dngtuankiet/aes-gcm_128-256/docs_v2/build_images/synthesis_100MHz.JPG

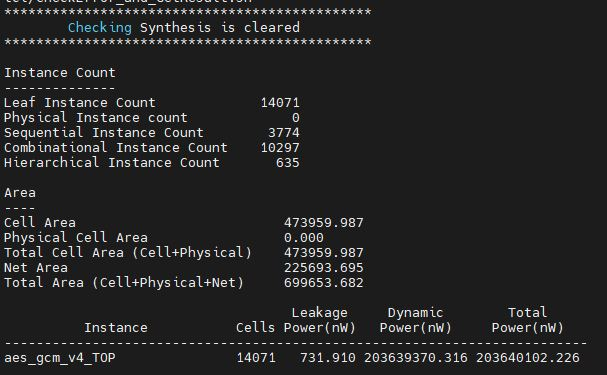
docs_v2/build_images/synthesis_100MHz.JPG
