dngtuankiet/aes-gcm_128-256/docs_v2/aes-gcm_v2/spec/spec.docx

AES-GCM

BLOCK DIAGRAMs

and STATE MACHINEs

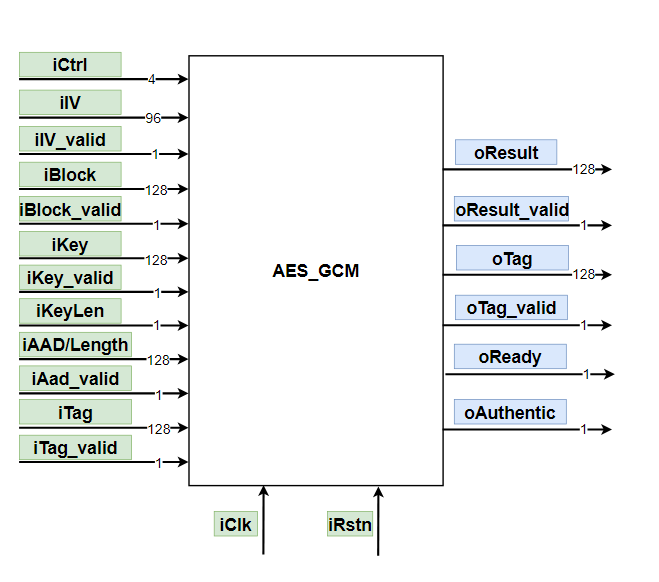
[picture p3: figure]

PIN | Direction | Width | Description
iClk | Input | 1 | Clock
iRstn | Input | 1 | Negative edge reset: reset after using the core

CONTROL
iCtrl | Input | ４ | Initialize signal: assert when using the core
oReady | Output | 1 | Output ready signal: input new data when ready is asserted

DATA
iIV | Input | 96 | 96-bit length IV
iIV_valid | Input | 1 | When asserted, IV is valid
iKey | Input | 256 | Key
iKey_valid | Input | 1 | When asserted, Key is valid
iKey_len | Input | 1 | When asserted, Key length is 256-bit. When deasserted, Key length is 128-bit.
iAad | Input | 128 | Additional Authentic Data or Length(A,C): when Ready = 1, change data every clock cycle
iAad_valid | Input | 1 | When asserted, AAD is valid.
iBlock | Input | 128 | Input Plaintext or Ciphertext.
iBlock_valid | Input | 1 | When asserted, Plaintext or Ciphertext is valid.
iTag | Input | 128 | Input Tag for authentication in Decryption mode
iTag_valid | Input | 1 | When asserted, Tag is valid

OUTPUT
oResult | Output | 128 | Output Ciphertext or Ciphertext
oResult_valid | Output | 1 | When asserted, Result is valid
oTag | Output | 128 | Output Tag in Encryption mode.
oTag_valid | Output | 1 | When asserted, output Tag is valid
oAuthentic | Output | 1 | When asserted, indicating authentic Block in Decryption mode.

Name | AES_GCM
File | aes_gcm.v

Submodule | File
GCTR_BLOCK | gctr_block.v
GHASH_BLOCK | ghash_block.v

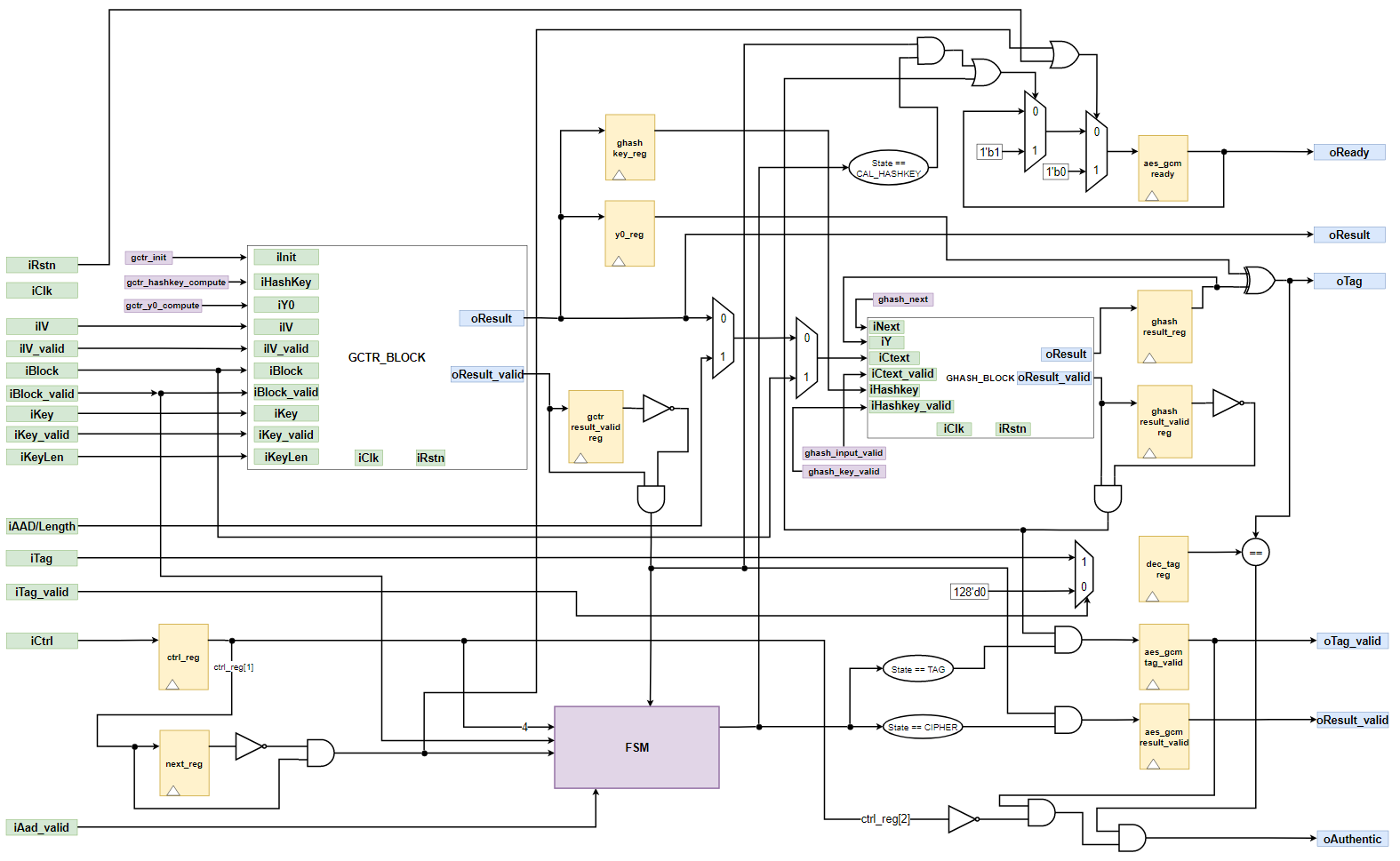
[picture p4: figure]
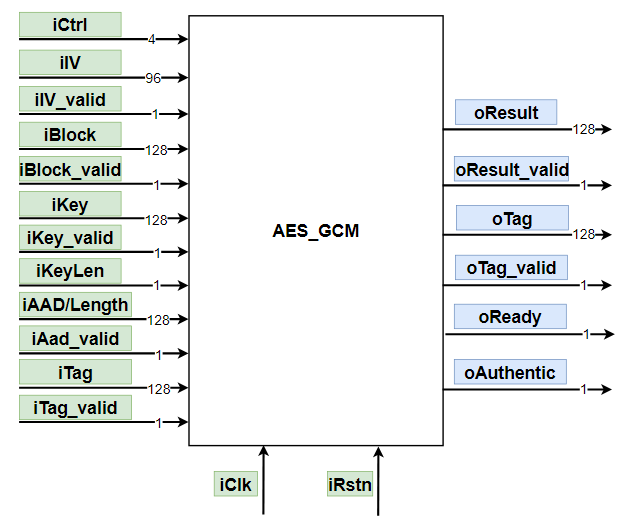
[picture p5: figure]
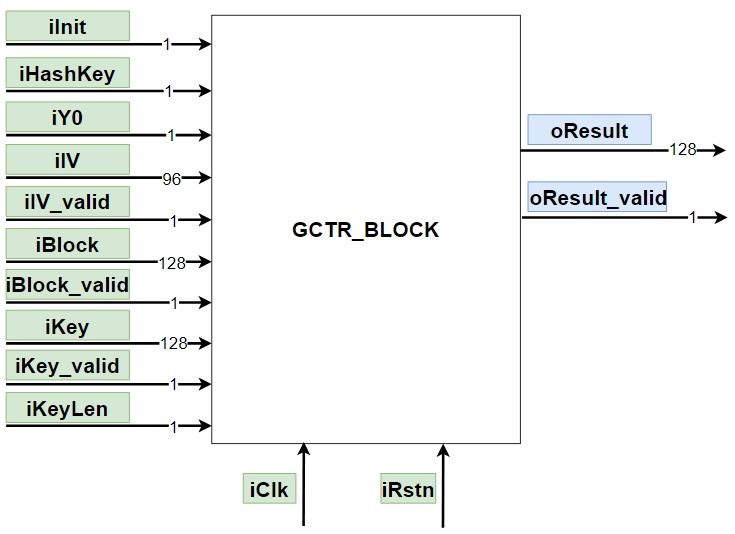
[picture p6: figure]
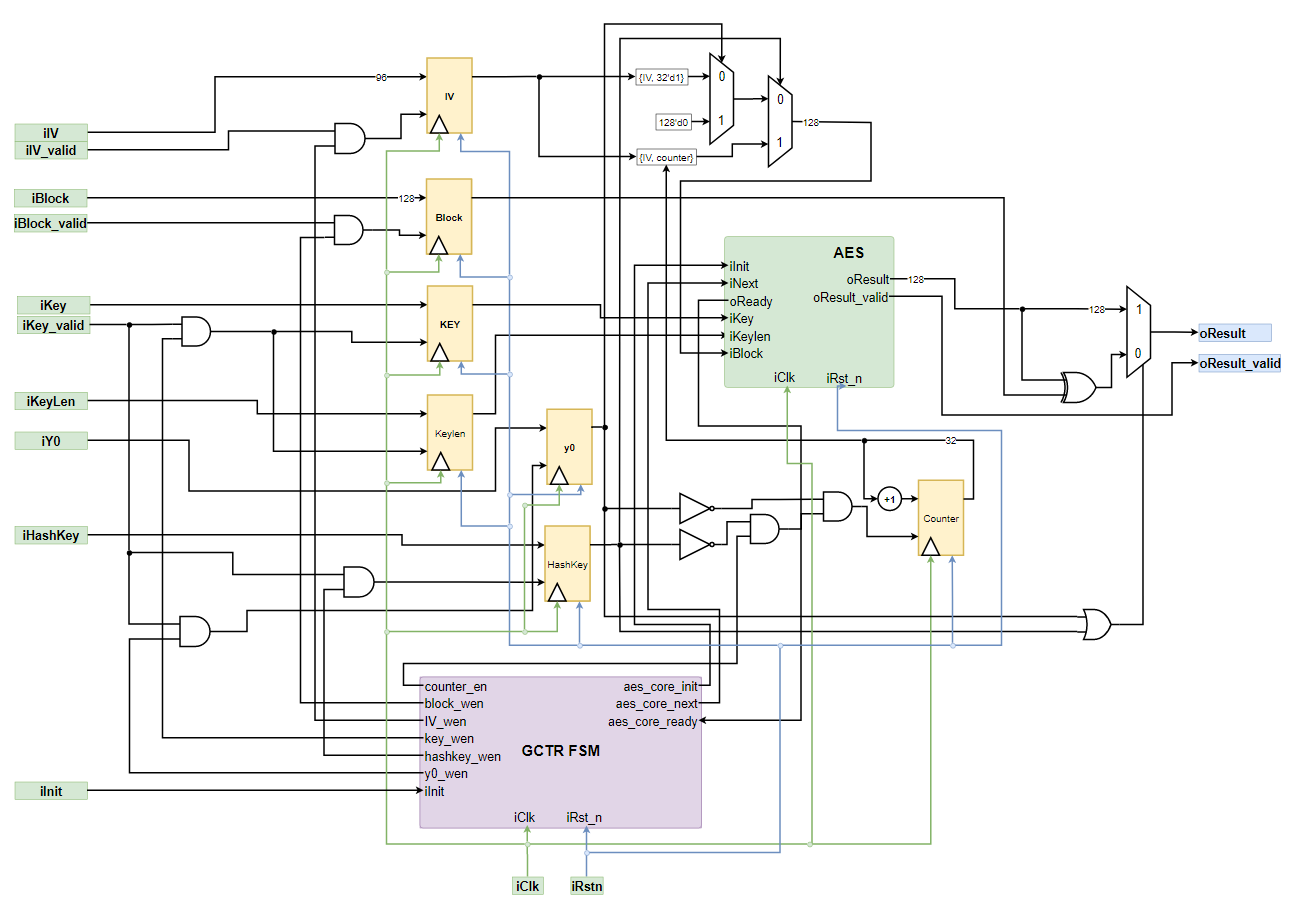
[picture p7: figure]

Submodule | File
AES | aes_core.v

Name | GCTR_BLOCK
File | gctr_block.v

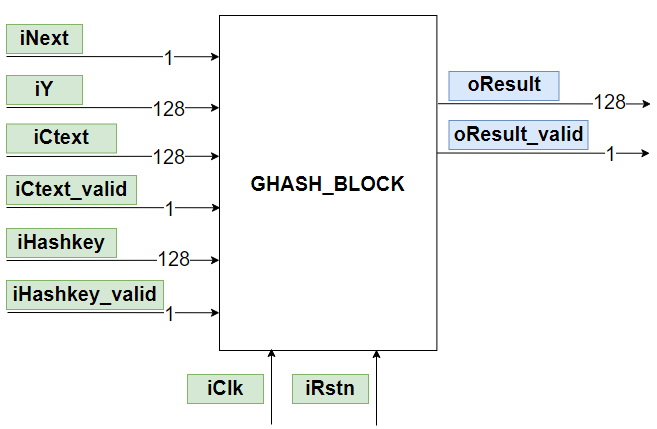
[picture p8: figure]
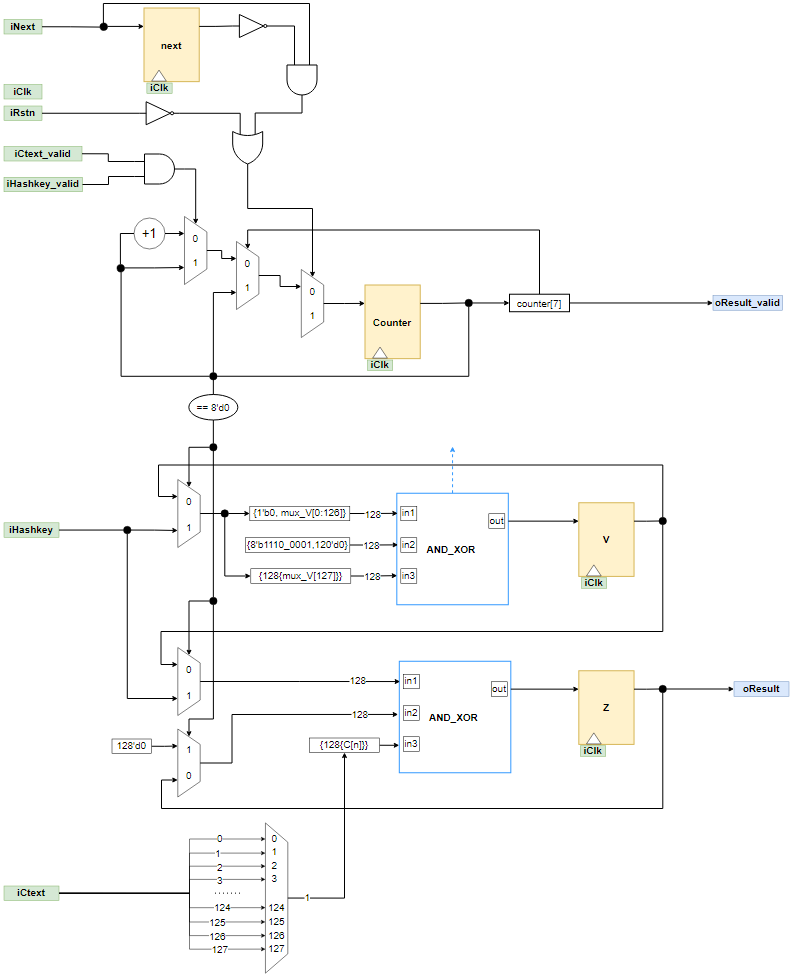
[picture p9: figure]
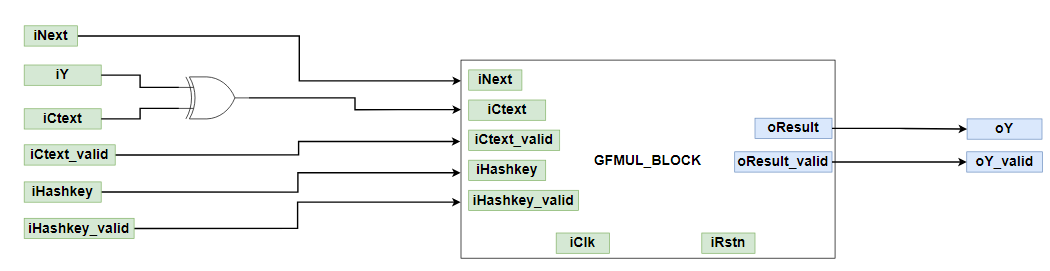
[picture p10: figure]

Submodule | File
GF_MUL | gfmul.v

Name | GHASH_BLOCK
File | ghash_block.v

STATE MACHINEs

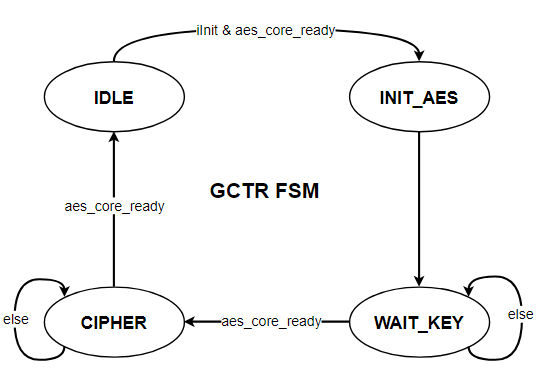
[picture p11: figure]
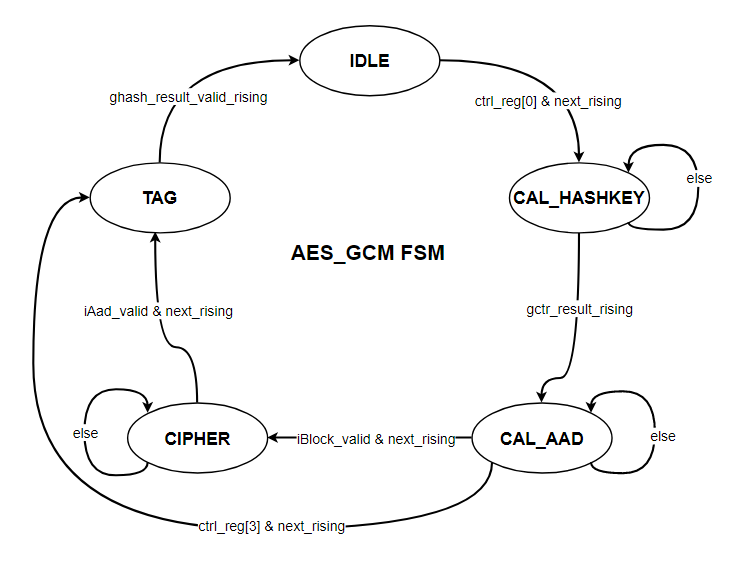
[picture p12: figure]

AES_GCM FSM

IDLE

gctr_init = 1’b0

gctr_hashkey_compute = 1’b0

gctr_y0_compute = 1’b0

ghash_next = 1’b0

ghash_input_signal = 2’b00

ghash_input_valid = 1’b0

ghash_key_wen = 1’b0

ghash_key_valid = 1’b0

ghash result_wen = 1’b0

y0_wen = 1’b0

CAL_HASHKEY

if(gctr_result_valid)

gctr_init = 1’b0

else

gctr_init = 1’b1

gctr_hashkey_compute = 1’b1

gctr_y0_compute = 1’b0

ghash_next = 1’b0

ghash_input_signal = 2’b00

ghash_input_valid = 1’b0

if(gctr_result_valid)

gctr_key_wen = 1’b1

gahsh_key_valid = 1’b1

else

gctr_key_wen = 1’b0

gahsh_key_valid = 1’b0

ghash_result_wen = 1’b0

y0_wen = 1’b0

CAL_AAD

if(next_rising & (iBlock_valid | ctrl_reg[3]))

gctr_init = 1’b1

else

gctr_init = 1’b0

gctr_hashkey_compute = 1’b0

gctr_y0_compute = 1’b0

ghash_next = next_rising

ghash_input_signal = 2’b01

ghash_input_valid = iAad_valid

ghash_key_wen = 1’b0

ghash_key_valid = 1’b1

if(ghash_result_valid_rising)

ghash_result_wen = 1’b1

else

ghash_result_wen = 1’b0

y0_wen = 1’b0

CIPHER

if(next_rising)

gctr_init = 1’b1

else

gctr_init = 1’b0

gctr_hashkey_compute = 1’b1

gctr_y0_compute = 1’b0

ghash_next = gctr_result_rising

if(ctrl_reg[2])

ghash_input_signal = 2’b00

else

ghash_input_signal = 2’b10

ghash_input_valid = gctr_result_valid

ghash_key_wen = 1’b0

ghash_key_valid = 1’b1

if(ghash_result_valid_rising)

ghash_result_wen = 1’b1

else

ghash_result_wen = 1’b0

y0_wen = 1’b0

TAG

gctr_init = 1’b0

gctr_hashkey_compute = 1’b0

gctr_y0_compute = 1’b1

ghash_next = gctr_result_rising

ghash_input_signal = 2’b01

ghash_input_valid = gctr_result_valid

ghash_key_wen = 1’b0

ghash_key_valid = 1’b1

if(ghash_result_valid_rising)

ghash_result_wen = 1’b1

else

ghash_result_wen = 1’b0

if(gctr_result_rising)

y0_wen = 1’b1

else

y0_wen = 1’b0

GCTR FSM

IDLE

counter_en = 1’b0

block_wen = 1’b0

IV_wen = 1’b0

key_wen = 1’b0

hashkey_wen = 1’b0

y0_wen = 1’b0

aes_core_init = 1’b0

aes_core_next = 1’b0

gctr_result_valid = aes_core_output_valid

INIT_AES

counter_en = 1’b0

block_wen = 1’b1

IV_wen = 1’b1

key_wen = 1’b1

hashkey_wen = 1’b1

y0_wen = 1’b1

aes_core_init = 1’b1

aes_core_next = 1’b0

gctr_result_valid = 1’b0

WAIT_KEY

counter_en = 1’b0

block_wen = 1’b0

IV_wen = 1’b0

key_wen = 1’b0

hashkey_wen = 1’b0

y0_wen = 1’b0

aes_core_init = 1’b0

aes_core_next = 1’b0

gctr_result_valid = 1’b0

CIPHER

counter_en = 1’b1

block_wen = 1’b0

IV_wen = 1’b0

key_wen = 1’b0

hashkey_wen = 1’b0

y0_wen = 1’b0

aes_core_init = 1’b0

aes_core_next = 1’b1

gctr_result_valid = 1’b0

Multiplication in GF(2¹²⁸)

Each element is a vector of 128 bits. The ith bit of an element X is denoted as Xi. The leftmost bit is Xi and the rightmost bit is X127. The multiplication operation uses the special element R = 1110001||0, and is defined in Algorithm 1. The argument rightshift() moves the bits of its argument one bit to the right. More formally, whenever W = rightshift(V), then Wi = Vi-1 for 1 <= i <= 127 and W0 = 0.

What we want to compute: oY = gf_mul(iHashKey, iCtext ^ iY)

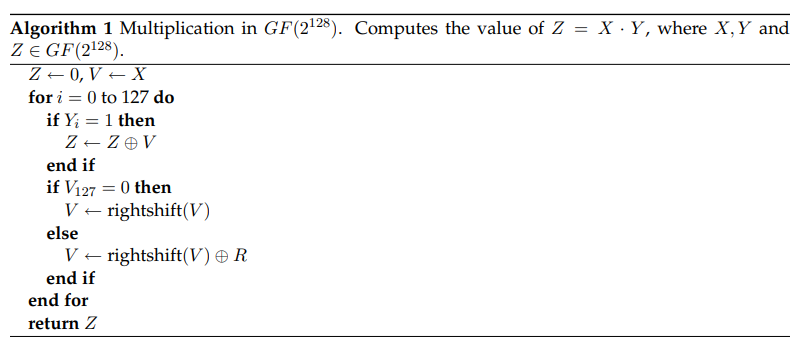
[picture p13: figure]
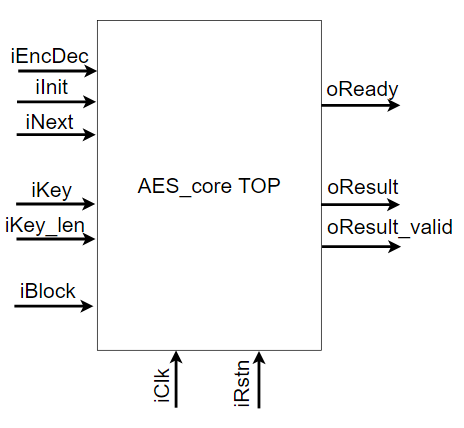
[picture p14: figure]

URL: tee-hardware/hardware/teehw/optvsrc/AES at master · uec-hanken/tee-hardware (github.com) (https://github.com/uec-hanken/tee-hardware/tree/master/hardware/teehw/optvsrc/AES)

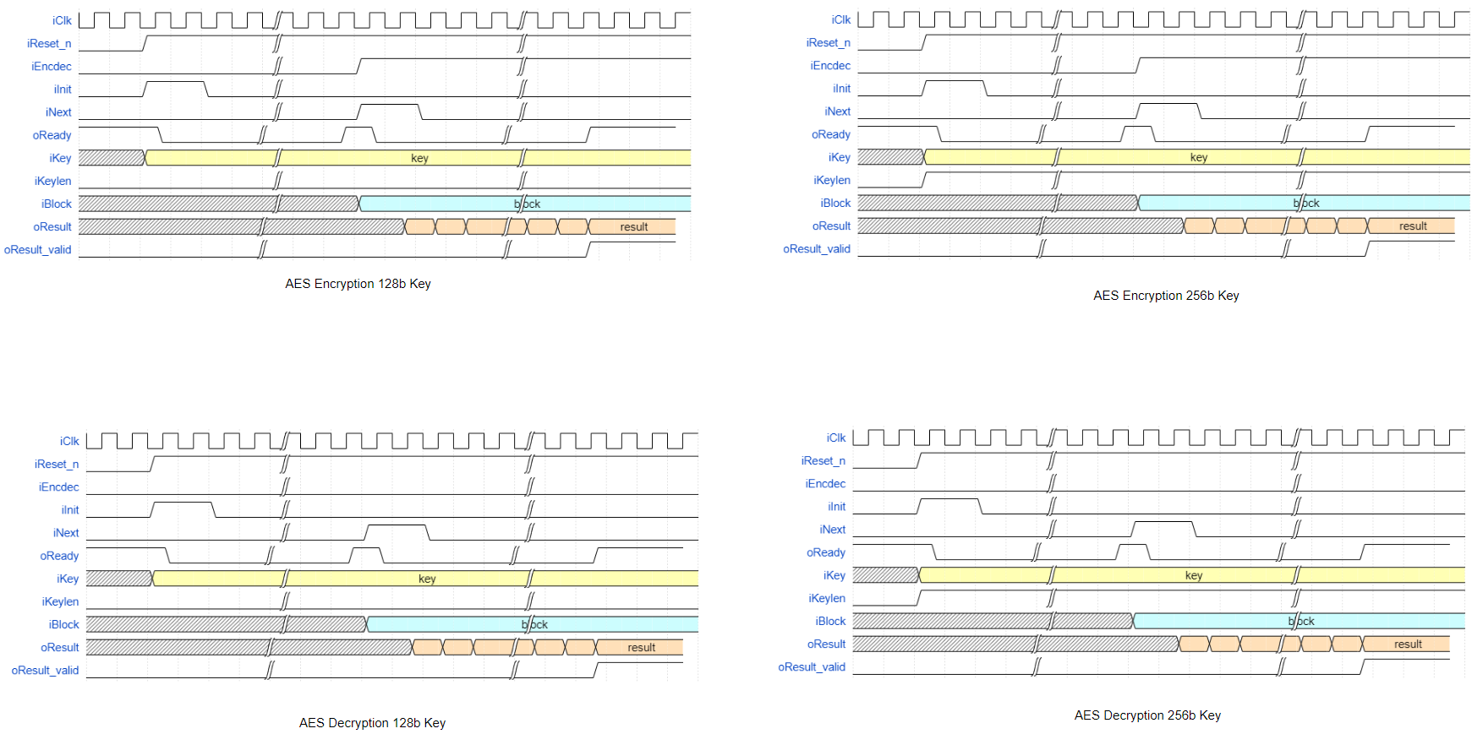
[picture p15: figure]
