dngtuankiet/aes-gcm_128-256/docs/new/spec.docx

AES GCM

BLOCK DIAGRAM

and STATE MACHINE

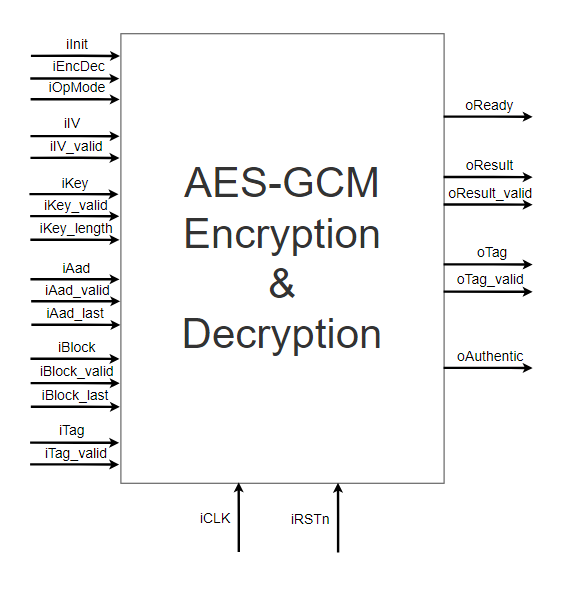
[picture p16: figure]
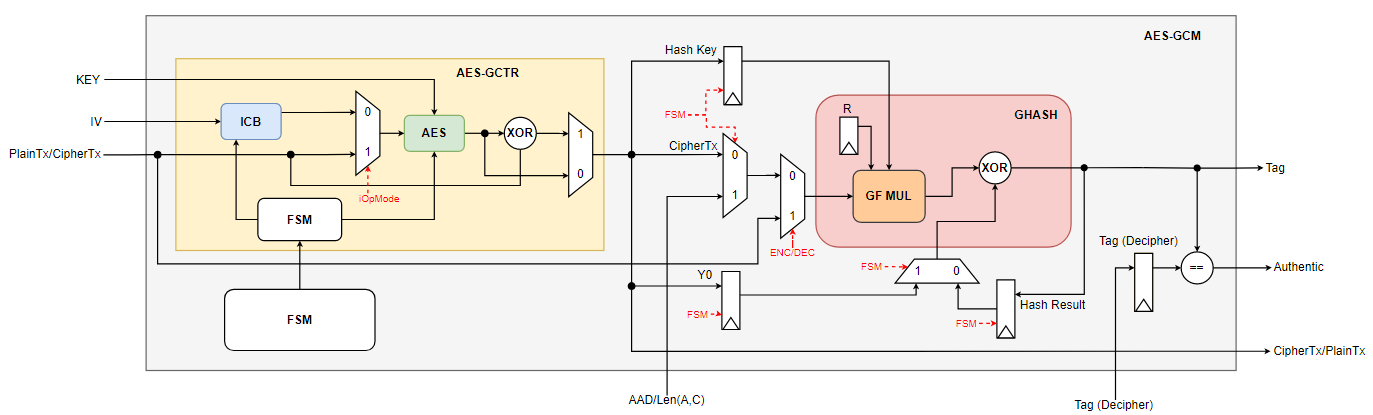
[picture p17: figure]

PIN | Direction | Width | Description
iClk | Input | 1 | Clock
iRstn | Input | 1 | Negative edge reset: reset after using the core
iInit | Input | 1 | Initialize signal: assert when using the core
iEncDec | Input | 1 | Assert for Encryption, deassert for Decryption
iOpMode | Input | 1 | Operation Mode: assert for AES-GCM, deassert for AES only
oReady | Output | 1 | Output ready signal: input new data when ready is asserted
iIV | Input | 96 | 96-bit length IV
iIV_valid | Input | 1 | When asserted, IV is valid
iKey | Input | 256 | Key
iKey_valid | Input | 1 | When asserted, Key is valid
iKey_len | Input | 1 | When asserted, Key length is 256-bit. When deasserted, Key length is 128-bit.
iAad | Input | 128 | Additional Authentic Data or Length(A,C): when Ready = 1, change data every clock cycle
iAad_valid | Input | 1 | When asserted, AAD is valid.
iAad_last | Input | 1 | Asserted when input the last AAD data.
iBlock | Input | 128 | Input Plaintext or Ciphertext.
iBlock_valid | Input | 1 | When asserted, Plaintext or Ciphertext is valid.
iBlock_last | Input | 1 | Asserted when input the last Block data.
iTag | Input | 128 | Input Tag for authentication in Decryption mode
iTag_valid | Input | 1 | When asserted, Tag is valid
oResult | Output | 128 | Output Ciphertext or Ciphertext
oResult_valid | Output | 1 | When asserted, Result is valid
oTag | Output | 128 | Output Tag in Encryption mode.
oTag_valid | Output | 1 | When asserted, output Tag is valid
oAuthentic | Output | 1 | When asserted, indicating authentic Block in Decryption mode.

Name | AES_GCM
File | aes_gcm.v

Submodule | File
AES_GCTR | aes_gcm.v
GHASH | ghash_block.v

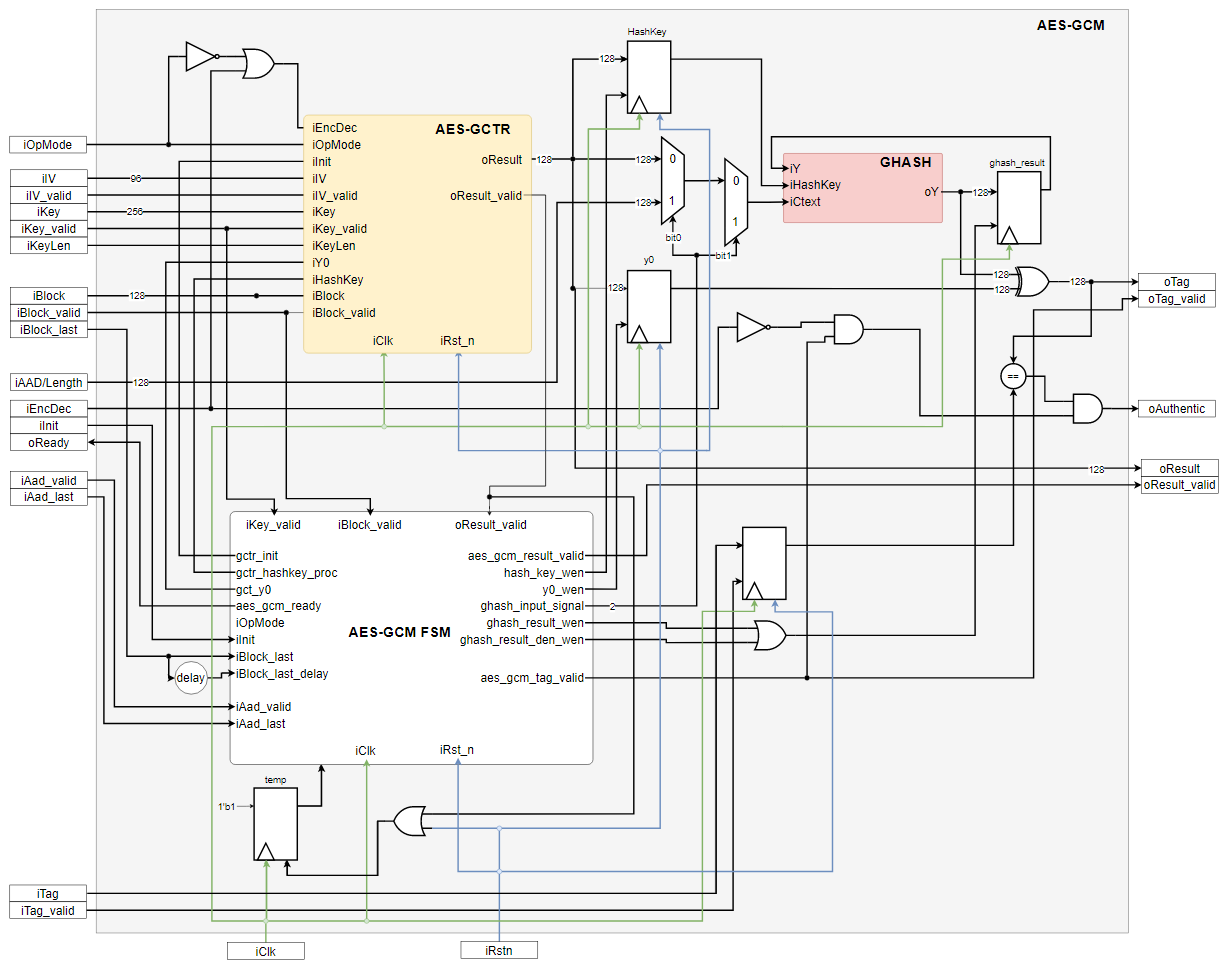
[picture p18: figure]
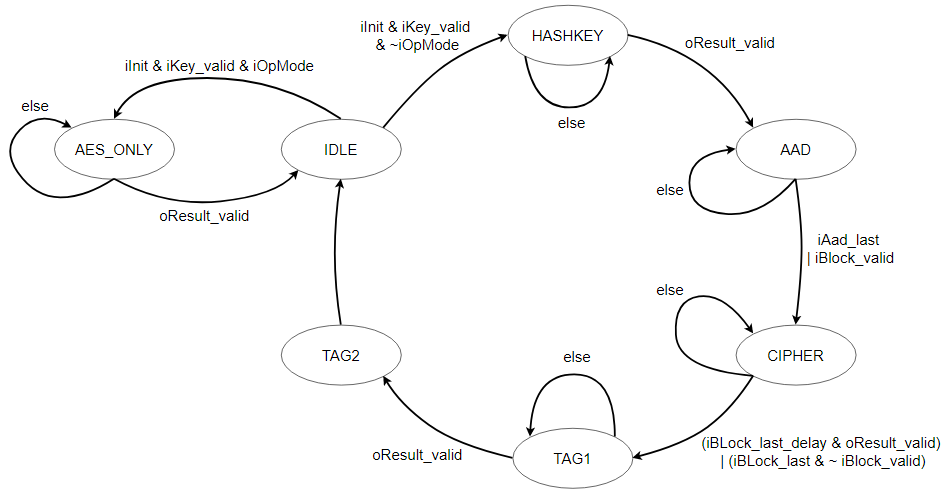
[picture p19: figure]
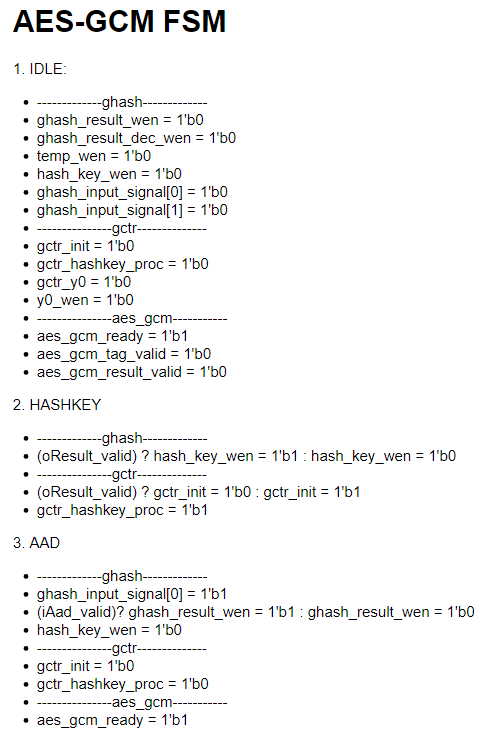
[picture p20: figure]
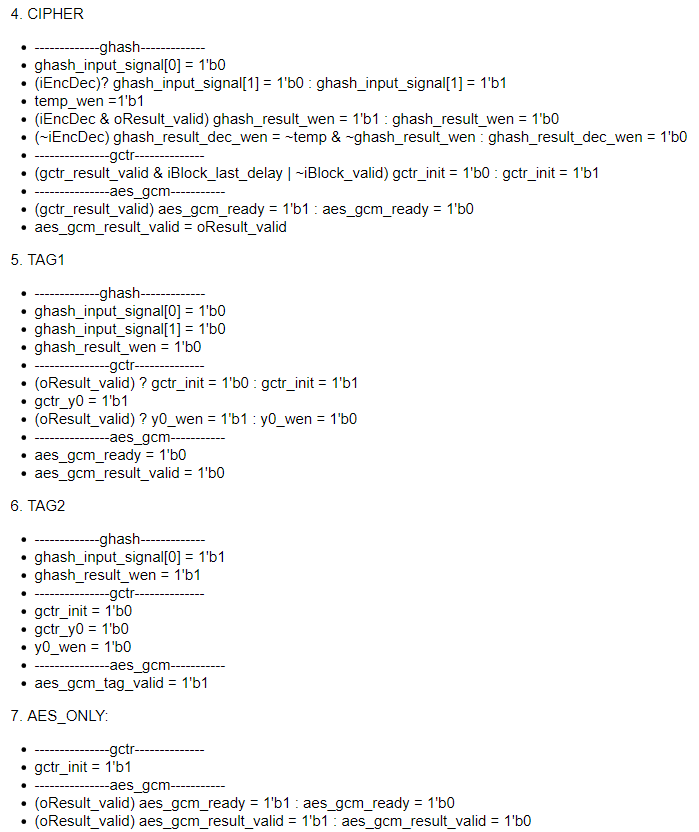
[picture p21: figure]

Submodule | File
AES_CORE | aes_core.v

Name | AES_GCM
File | aes_gcm.v

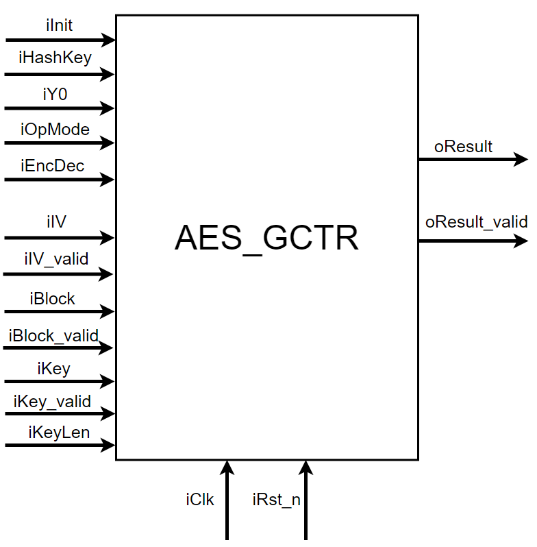
[picture p22: figure]
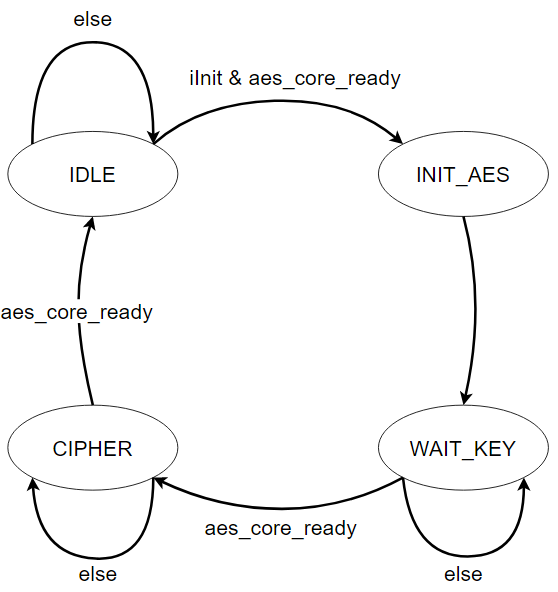
[picture p23: figure]
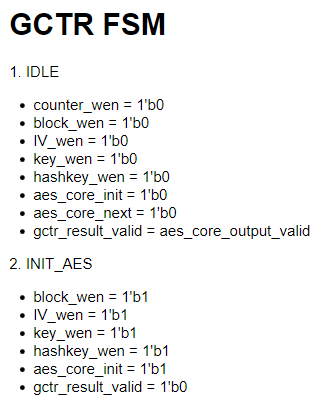
[picture p24: figure]
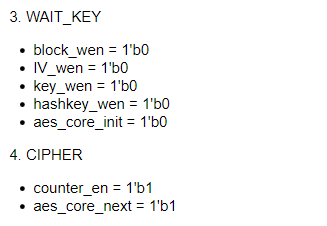
[picture p25: figure]
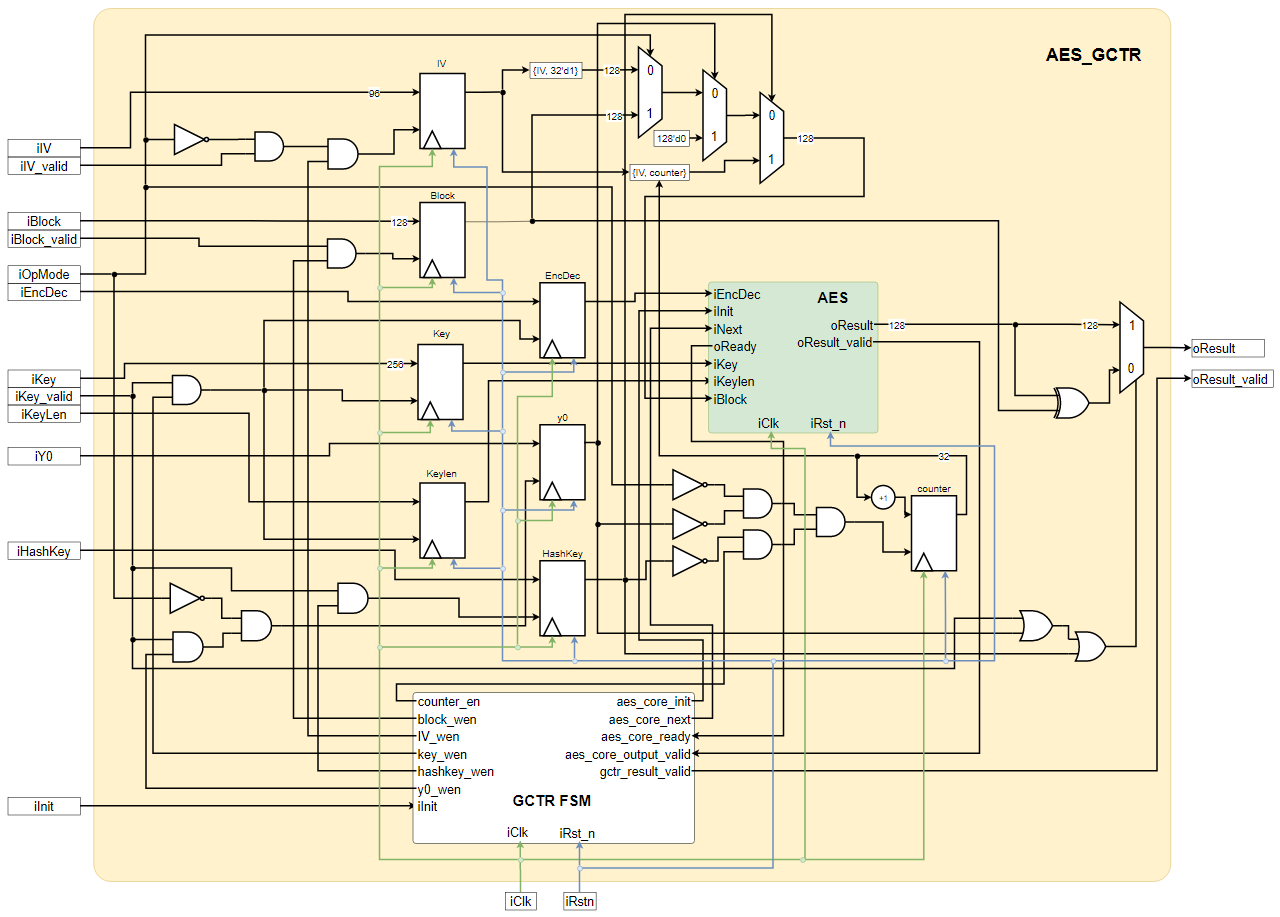
[picture p26: figure]
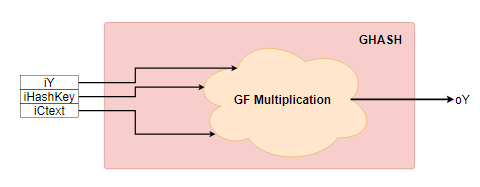
[picture p27: figure]

Multiplication in GF(2¹²⁸)

Each element is a vector of 128 bits. The ith bit of an element X is denoted as Xi. The leftmost bit is Xi and the rightmost bit is X127. The multiplication operation uses the special element R = 1110001||0, and is defined in Algorithm 1. The argument rightshift() moves the bits of its argument one bit to the right. More formally, whenever W = rightshift(V), then Wi = Vi-1 for 1 <= i <= 127 and W0 = 0.

What we want to compute: oY = gf_mul(iHashKey, iCtext ^ iY)


URL: tee-hardware/hardware/teehw/optvsrc/AES at master · uec-hanken/tee-hardware (github.com) (https://github.com/uec-hanken/tee-hardware/tree/master/hardware/teehw/optvsrc/AES)
