dngtuankiet/aes-gcm_128-256/(list of files, cad)

Other CAD files:
modelsim/work/aes_core/verilog.psm
modelsim/work/aes_core_@t@o@p/verilog.psm
modelsim/work/aes_core_@t@o@p_wrapper/verilog.psm
modelsim/work/aes_decipher_block/verilog.psm
modelsim/work/aes_encipher_block/verilog.psm
modelsim/work/aes_gcm/verilog.psm
modelsim/work/aes_gcm_@t@o@p/verilog.psm
modelsim/work/aes_inv_sbox/verilog.psm
modelsim/work/aes_key_mem/verilog.psm
modelsim/work/aes_sbox/verilog.psm
modelsim/work/aes_sub_inv_sbox/verilog.psm
modelsim/work/aes_sub_sbox/verilog.psm
modelsim/work/gctr_block/verilog.psm
modelsim/work/gfmul/verilog.psm
modelsim/work/ghash_block/verilog.psm
modelsim/work/inv_mixcolumns/verilog.psm
modelsim/work/inv_mixw/verilog.psm
modelsim/work/k_tb/verilog.psm
modelsim/work/mixcolumns/verilog.psm
modelsim/work/mixw/verilog.psm
modelsim/work/tb_aes_core/verilog.psm
modelsim/work/tb_aes_gcm/verilog.psm
modelsim/work/tb_gctr/verilog.psm
modelsim/work/tb_gfmul/verilog.psm
source_v1_mod/modelsim/work/aes_core/verilog.psm
source_v1_mod/modelsim/work/aes_core_@t@o@p/verilog.psm
source_v1_mod/modelsim/work/aes_core_@t@o@p_wrapper/verilog.psm
source_v1_mod/modelsim/work/aes_encipher_block/verilog.psm
source_v1_mod/modelsim/work/aes_gcm_v4/verilog.psm
source_v1_mod/modelsim/work/aes_gcm_v4_@t@o@p/verilog.psm
source_v1_mod/modelsim/work/aes_key_mem/verilog.psm
source_v1_mod/modelsim/work/aes_sbox/verilog.psm
source_v1_mod/modelsim/work/aes_sub_sbox/verilog.psm
source_v1_mod/modelsim/work/gctr_block_v2/verilog.psm
source_v1_mod/modelsim/work/gfmul/verilog.psm
source_v1_mod/modelsim/work/gfmul_v2/verilog.psm
source_v1_mod/modelsim/work/ghash_block/verilog.psm
source_v1_mod/modelsim/work/ghash_block_v2/verilog.psm
source_v1_mod/modelsim/work/k_tb/verilog.psm
source_v1_mod/modelsim/work/mixcolumns/verilog.psm
source_v1_mod/modelsim/work/mixw/verilog.psm
source_v1_mod/modelsim/work/tb_aes_core/verilog.psm
source_v1_mod/modelsim/work/tb_aes_gcm_v4/verilog.psm
source_v1_mod/modelsim/work/tb_gctr_v2/verilog.psm
source_v1_mod/modelsim/work/tb_gfmul_v2/verilog.psm
