dngtuankiet/aes-gcm_128-256/docs/new/use_guide.docx

AES-GCM USE GUIDE


PIN | Direction | Width | Description
iClk | Input | 1 | Clock
iRstn | Input | 1 | Negative edge reset: reset after using the core
iInit | Input | 1 | Initialize signal: assert when using the core
iEncDec | Input | 1 | Assert for Encryption, deassert for Decryption
iOpMode | Input | 1 | Operation Mode: assert for AES-GCM, deassert for AES only
oReady | Output | 1 | Output ready signal: input new data when ready is asserted
iIV | Input | 96 | 96-bit length IV
iIV_valid | Input | 1 | When asserted, IV is valid
iKey | Input | 256 | Key
iKey_valid | Input | 1 | When asserted, Key is valid
iKey_len | Input | 1 | When asserted, Key length is 256-bit. When deasserted, Key length is 128-bit.
iAad | Input | 128 | Additional Authentic Data or Length(A,C): when Ready = 1, change data every clock cycle
iAad_valid | Input | 1 | When asserted, AAD is valid.
iAad_last | Input | 1 | Asserted when input the last AAD data.
iBlock | Input | 128 | Input Plaintext or Ciphertext.
iBlock_valid | Input | 1 | When asserted, Plaintext or Ciphertext is valid.
iBlock_last | Input | 1 | Asserted when input the last Block data.
iTag | Input | 128 | Input Tag for authentication in Decryption mode
iTag_valid | Input | 1 | When asserted, Tag is valid
oResult | Output | 128 | Output Ciphertext or Ciphertext
oResult_valid | Output | 1 | When asserted, Result is valid
oTag | Output | 128 | Output Tag in Encryption mode.
oTag_valid | Output | 1 | When asserted, output Tag is valid
oAuthentic | Output | 1 | When asserted, indicating authentic Block in Decryption mode.

AES-GCM Testbench

Testcase 1: AES-GCM Encryption 256-bit Key with both AAD and Plaintext

KEY: 256'hE3C08A8F06C6E3AD95A70557B23F75483CE33021A9C72B7025666204C69C0B72

BLOCK: 128'h08000F101112131415161718191A1B1C

128'h1D1E1F202122232425262728292A2B2C

128'h2D2E2F303132333435363738393A0002

AAD: 128'hD609B1F056637A0D46DF998D88E52E00

128'hB2C2846512153524C0895E81_00000000

IV: 96'h12153524C0895E81B2C28465

LEN(A,C): 128'h00000000000000E0_0000000000000180

Expected Outputs:

CIPHER: 128'hE2006EB42F5277022D9B19925BC419D7

128'hA592666C925FE2EF718EB4E308EFEAA7

128'hC5273B394118860A5BE2A97F56AB7836

TAG 128'h5CA597CDBB3EDB8D1A1151EA0AF7B436

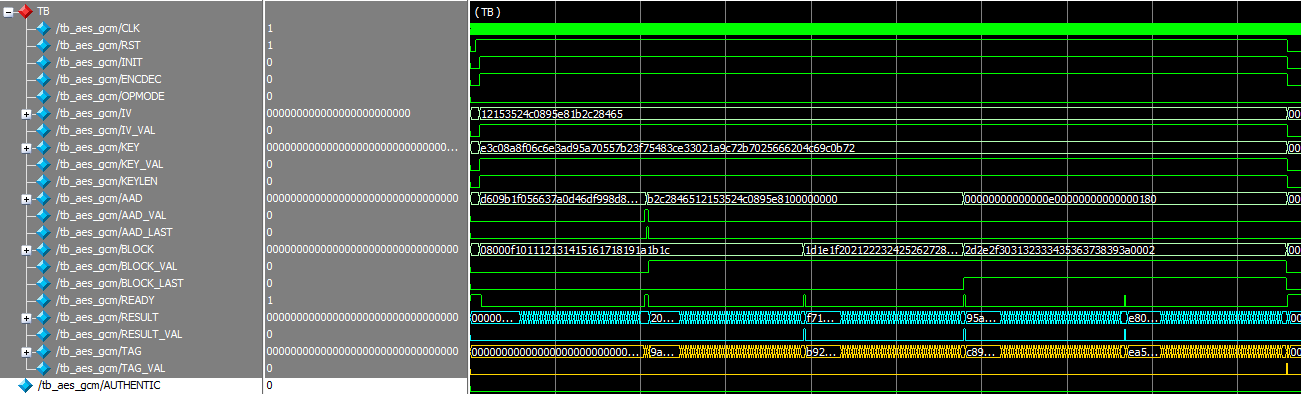
[picture p30: figure]

Testcase 2: AES-GCM Encryption 128-bit Key with both AAD and Plaintext

KEY: {128'hAD7A2BD03EAC835A6F620FDCB506B345, 128'd0}

BLOCK: 128'h08000F101112131415161718191A1B1C

128'h1D1E1F202122232425262728292A2B2C

128'h2D2E2F303132333435363738393A0002

AAD: 128'hD609B1F056637A0D46DF998D88E52E00

128'hB2C2846512153524C0895E81_00000000

IV: 96'h12153524C0895E81B2C28465

LEN(A,C): 128'h00000000000000E0_0000000000000180

Expected Outputs:

CIPHER: 128'h701AFA1CC039C0D765128A665DAB6924

128'h3899BF7318CCDC81C9931DA17FBE8EDD

128'h7D17CB8B4C26FC81E3284F2B7FBA713D

TAG 128'h4F8D55E7D3F06FD5A13C0C29B9D5B880

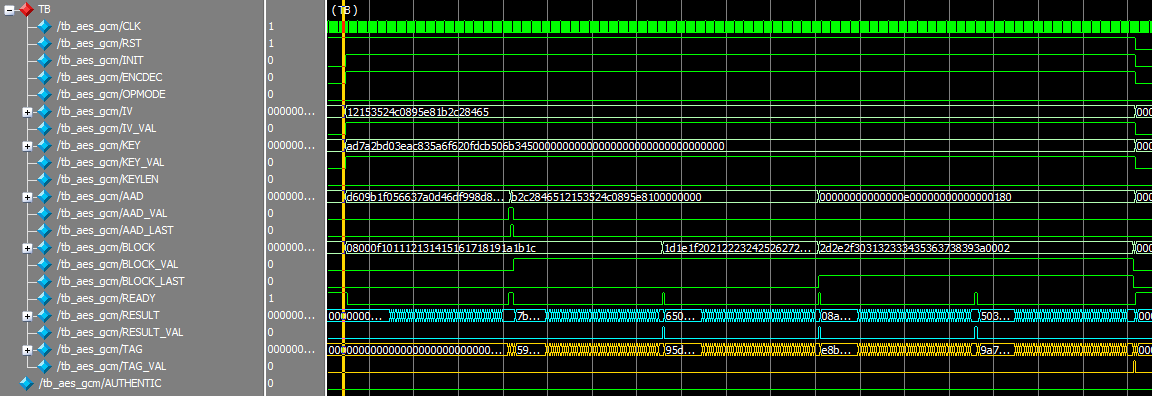
[picture p31: figure]

Testcase 3: AES-GCM Encryption 256-bit Key with only Plaintext

KEY: 256'hFEFFE9928665731C6D6A8F9467308308_FEFFE9928665731C6D6A8F9467308308

BLOCK: 128'hD9313225F88406E5A55909C5AFF5269A

128'h86A7A9531534F7DA2E4C303D8A318A72

128'h1C3C0C95956809532FCF0E2449A6B525

128'hB16AEDF5AA0DE657BA637B391AAFD255

IV: 96'hCAFEBABEFACEDBADDECAF888

LEN(A,C): 128'h00000000000000000000000000000200

Expected Outputs:

CIPHER: 128'h522DC1F099567D07F47F37A32A84427D

128'h643A8CDCBFE5C0C97598A2BD2555D1AA

128'h8CB08E48590DBB3DA7B08B1056828838

128'hC5F61E6393BA7A0ABCC9F662898015AD

TAG 128'hB094DAC5D93471BDEC1A502270E3CC6C

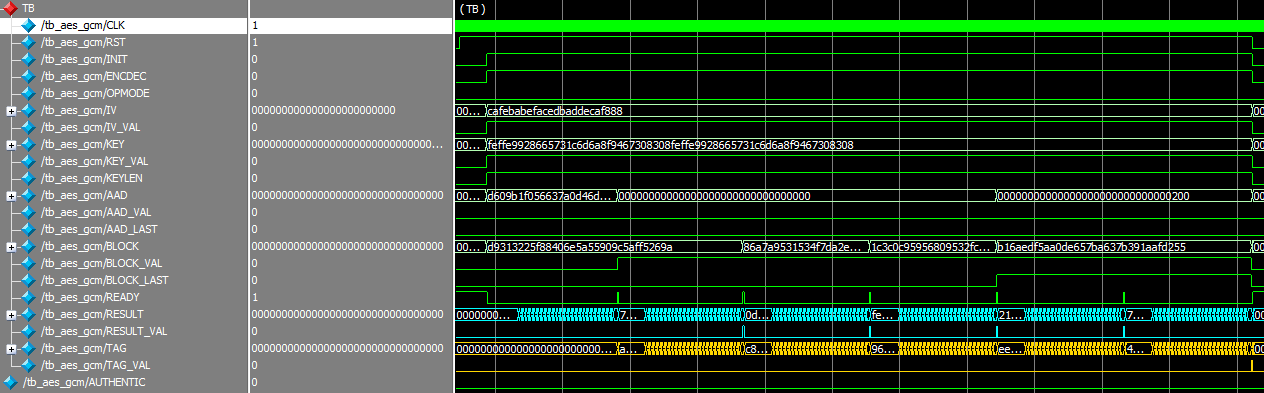
[picture p32: figure]

Testcase 4: AES-GCM Encryption 256-bit Key with only AAD

KEY: 256'h83C093B58DE7FFE1C0DA926AC43FB360_9AC1C80FEE1B624497EF942E2F79A823

AAD: 128'h84C5D513D2AAF6E5BBD2727788E52300

128'h8932D6127CFDE9F9E33724C608000F10

128'h1112131415161718191A1B1C1D1E1F20

128'h2122232425262728292A2B2C2D2E2F30

128'h3132333435363738393A3B3C3D3E3F00

128'h05000000000000000000000000000000

IV: 96'h7CFDE9F9E33724C68932D612

LEN(A,C): 128'h0000000000000288_0000000000000000

Expected Outputs:

TAG 128'h6EE160E8FAECA4B36C86B234920CA975

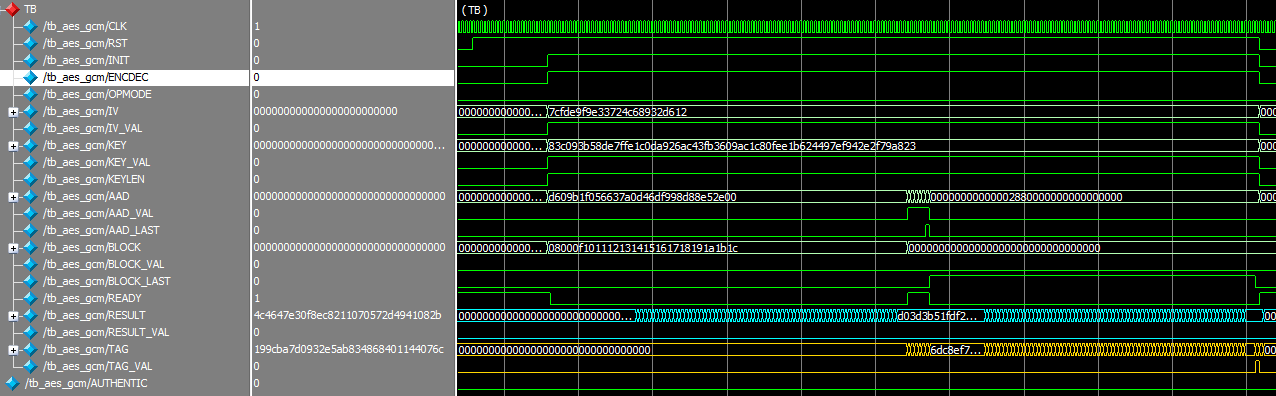
[picture p33: figure]

Testcase 5: AES-GCM Decryption 256-bit Key with both AAD and Plaintext

KEY: 256'hE3C08A8F06C6E3AD95A70557B23F75483CE33021A9C72B7025666204C69C0B72

BLOCK: 128'hE2006EB42F5277022D9B19925BC419D7

128'hA592666C925FE2EF718EB4E308EFEAA7

128'hC5273B394118860A5BE2A97F56AB7836

AAD: 128'hD609B1F056637A0D46DF998D88E52E00

128'hB2C2846512153524C0895E81_00000000

IV: 96'h12153524C0895E81B2C28465

LEN(A,C): 128'h00000000000000E0_0000000000000180

Expected Outputs:

CIPHER: 128'h08000F101112131415161718191A1B1C

128'h1D1E1F202122232425262728292A2B2C

128'h2D2E2F303132333435363738393A0002

TAG 128'h5CA597CDBB3EDB8D1A1151EA0AF7B436

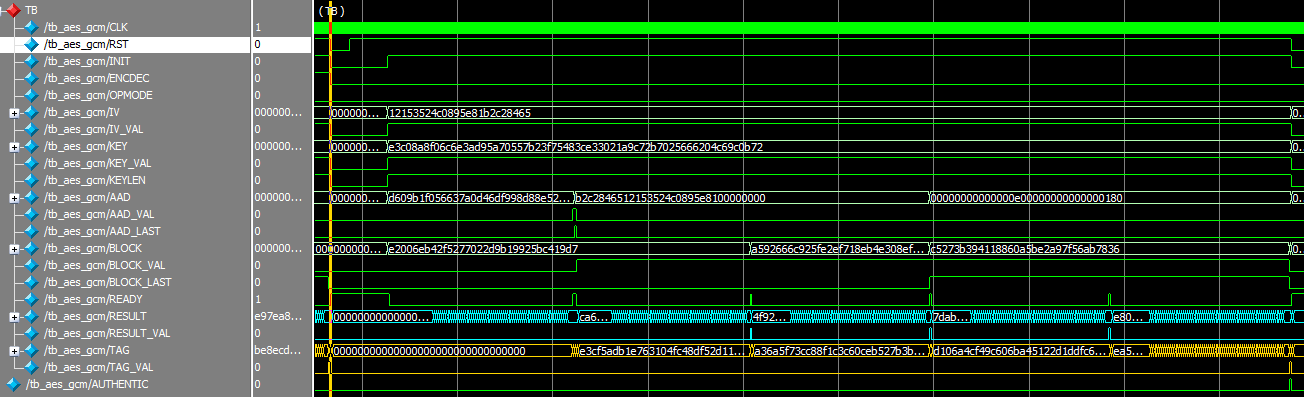
[picture p34: figure]

Use Guide AES-GCM

Testbench Signal Descriptions

1. Control signals:
- RST: reset LOW. Perform reset after finish using the core
- INIT: Initialize the core. Set to HIGH when input data to the core, and keep HIGH the whole time when using the core. Set to LOW after finish using the core.
- ENCDEC: HIGH – Perform encryption. LOW - Perform decryption.
- OPMODE: operation mode. HIGH – AES only. LOW – AES-GCM.
- KEYLEN: indicate the length of the input key. HIGH – 256b key. LOW – 128b key.
- AAD_LAST: set to HIGH when input the last AAD data.
2. Input data signals:
- KEY: input key
- KEY_VAL: indicate valid input key. Set to HIGH when the input key is valid.
- AAD: input AAD or input length (len(A,C)).
- AAD_VAL: indicate valid input AAD. Set to HIGH when the input AAD is valid. When input len(A,C), don’t care about this signal
- BLOCK: input block.
- BLOCK_VAL: indicate valid input block. Set to HIGH when the input block is valid.
- BLOCK_LAST:
3. Output signals:
- READY: the core is ready to accept input data. Input data or change data to new one when this signal is HIGH.
- RESULT: output ciphertext or plaintext
- RESULT_VALID: indicate the output ciphertext or plaintext is valid. Read the value of RESULT when this signal is HIGH
- TAG: output tag
- TAG_VALID: indicate the output tag is valid. Read the value of TAG when this signal is HIGH.
I. With both AAD and Plaintext/Ciphertext
1. After the core is reset, the READY signal is HIGH.
2. Set control signals (INIT, OPMODE, ENCDEC, KEYLEN), input KEY + valid key, and input IV + valid IV.

At this step, the core is calculating HashKey.

3. Wait for READY signal. At this step, the HashKey is calculated.
4. Input AAD + valid AAD (if input the last AAD, set the AAD_LAST).

Note: Change each AAD data every clock rising edges.

5. After input the last AAD, input the first BLOCK data + valid BLOCK.

At this step, the core is calculating the first Ciphertext/Plaintext.

6. Wait for READY signal (or RESULT_VAL). At this step, the first Ciphertext/Plaintext is calculated.
7. Repeat step 5 & 6 until the last BLOCK data (if input the last BLOCK, set the BLOCK_LAST and input the length(A,C))
8. After input the last BLOCK, wait for READY signal (or RESULT_VALID) to get the last Ciphertext/Plaintext.
9. Wait for TAG_VAL signal to get the output TAG.
10. Reset the core
II. With only Plaintext/Ciphertext

Skip step 4 in I.

III. With only ADD

Do step 1-4 in I.

5. After input the last AAD, set BLOCK_LAST signal (only this signal).

6. Wait for TAG_VAL signal the get the output TAG.

7. Reset the core

Use Guide AES only

Testcase 6 and 7: AES only in Encryption and Decryption mode

KEY: 256'h000102030405060708090a0b0c0d0e0f101112131415161718191a1b1c1d1e1f

BLOCK: 128'h00112233445566778899aabbccddeeff

CIPHER: 128'h8ea2b7ca516745bfeafc49904b496089

Note: Swap BLOCK and CIPHER for Decryption mode in testcase 7

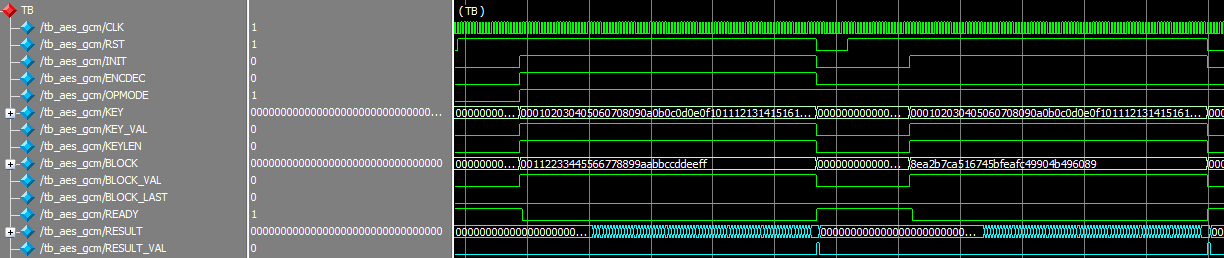
[picture p35: figure]

Use guide:

1. After the core is reset, the READY signal is HIGH.
2. Set control signal (INIT, OPMODE, ENCDEC, KEYLEN), input KEY + valid KEY, input BLOCK + valid BLOCK
3. Wait for READY (or RESULT_VAL) to get the Ciphertext/Plaintext.
