dngtuankiet/aes-gcm_128-256/source_v1/aes_gcm/aes_gcm_TOP.v

module aes_gcm_TOP(
//6 pins
input ICLK,
input IRSTN,
input IINIT,
input IENCDEC,
input IOPMODE,
output OREADY,

//355 pins
input [0:95] IIV,
input IIV_VALID,
input [0:255] IKEY,
input IKEY_VALID,
input IKEYLEN,

//130 pins
input [0:127] IAAD,
input IAAD_VALID,
input IAAD_LAST,

//130 pins
input [0:127] IBLOCK,
input IBLOCK_VALID,
input IBLOCK_LAST,

//129 pins
input [0:127] ITAG,
input ITAG_VALID,

//259 pins
output [0:127] ORESULT,
output ORESULT_VALID,
output [0:127] OTAG,
output OTAG_VALID,
output OAUTHENTIC
);

aes_gcm U1(
.iClk(ICLK),
.iRstn(IRSTN),
.iInit(IINIT),
.iEncdec(IENCDEC),
.iOpMode(IOPMODE),
.oReady(OREADY),

.iIV(IIV),
.iIV_valid(IIV_VALID),
.iKey(IKEY),
.iKey_valid(IKEY_VALID),
.iKeylen(IKEYLEN),

.iAad(IAAD), //Len
.iAad_valid(IAAD_VALID),
.iAad_last(IAAD_LAST),

.iBlock(IBLOCK),
.iBlock_valid(IBLOCK_VALID),
.iBlock_last(IBLOCK_LAST),

.iTag(ITAG),
.iTag_valid(ITAG_VALID),

.oResult(ORESULT),
.oResult_valid(ORESULT_VALID),
.oTag(OTAG),
.oTag_valid(OTAG_VALID),
.oAuthentic(OAUTHENTIC)
);

endmodule
