dngtuankiet/aes-gcm_128-256/docs_v2/aes-gcm_v2/source_v2/aes_core/aes_sub_sbox.v

module aes_sub_sbox(
	input		[7:0]	in,
	output	reg	[7:0]	out
);

 always@(*) begin
	case(in)
		8'h00: begin
			out = 8'h63;
		end
		8'h01: begin
			out = 8'h7c;
		end
		8'h02: begin
			out = 8'h77;
		end
		8'h03: begin
			out = 8'h7b;
		end
		8'h04: begin
			out = 8'hf2;
		end
		8'h05: begin
			out = 8'h6b;
		end
		8'h06: begin
			out = 8'h6f;
		end
		8'h07: begin
			out = 8'hc5;
		end
		8'h08: begin
			out = 8'h30;
		end
		8'h09: begin
			out = 8'h01;
		end
		8'h0a: begin
			out = 8'h67;
		end
		8'h0b: begin
			out = 8'h2b;
		end
		8'h0c: begin
			out = 8'hfe;
		end
		8'h0d: begin
			out = 8'hd7;
		end
		8'h0e: begin
			out = 8'hab;
		end
		8'h0f: begin
			out = 8'h76;
		end
		8'h10: begin
			out = 8'hca;
		end
		8'h11: begin
			out = 8'h82;
		end
		8'h12: begin
			out = 8'hc9;
		end
		8'h13: begin
			out = 8'h7d;
		end
		8'h14: begin
			out = 8'hfa;
		end
		8'h15: begin
			out = 8'h59;
		end
		8'h16: begin
			out = 8'h47;
		end
		8'h17: begin
			out = 8'hf0;
		end
		8'h18: begin
			out = 8'had;
		end
		8'h19: begin
			out = 8'hd4;
		end
		8'h1a: begin
			out = 8'ha2;
		end
		8'h1b: begin
			out = 8'haf;
		end
		8'h1c: begin
			out = 8'h9c;
		end
		8'h1d: begin
			out = 8'ha4;
		end
		8'h1e: begin
			out = 8'h72;
		end
		8'h1f: begin
			out = 8'hc0;
		end
		8'h20: begin
			out = 8'hb7;
		end
		8'h21: begin
			out = 8'hfd;
		end
		8'h22: begin
			out = 8'h93;
		end
		8'h23: begin
			out = 8'h26;
		end
		8'h24: begin
			out = 8'h36;
		end
		8'h25: begin
			out = 8'h3f;
		end
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
			out = 8'h9b;
		end
		8'he9: begin
			out = 8'h1e;
		end
		8'hea: begin
			out = 8'h87;
		end
		8'heb: begin
			out = 8'he9;
		end
		8'hec: begin
			out = 8'hce;
		end
		8'hed: begin
			out = 8'h55;
		end
		8'hee: begin
			out = 8'h28;
		end
		8'hef: begin
			out = 8'hdf;
		end
		8'hf0: begin
			out = 8'h8c;
		end
		8'hf1: begin
			out = 8'ha1;
		end
		8'hf2: begin
			out = 8'h89;
		end
		8'hf3: begin
			out = 8'h0d;
		end
		8'hf4: begin
			out = 8'hbf;
		end
		8'hf5: begin
			out = 8'he6;
		end
		8'hf6: begin
			out = 8'h42;
		end
		8'hf7: begin
			out = 8'h68;
		end
		8'hf8: begin
			out = 8'h41;
		end
		8'hf9: begin
			out = 8'h99;
		end
		8'hfa: begin
			out = 8'h2d;
		end
		8'hfb: begin
			out = 8'h0f;
		end
		8'hfc: begin
			out = 8'hb0;
		end
		8'hfd: begin
			out = 8'h54;
		end
		8'hfe: begin
			out = 8'hbb;
		end
		8'hff: begin
			out = 8'h16;
		end
	endcase
 end

endmodule
