dngtuankiet/aes-gcm_128-256/source_v1_mod/src/gfmul.v

module gfmul(
//input [0:127] iR,
input [0:127] iCtext,
input [0:127] iHashkey,
output [0:127] oResult
);

// reg [0:127] Z;
// reg [0:127] V;
// integer idx;

// always @(*) begin
	// Z = 128'd0;
	// V = iHashkey;

	// for(idx = 0; idx <= 127; idx = idx + 1) begin
		// if(iCtext[idx])	Z = Z ^ V;
		// else			Z = Z;
		
		// if(~V[127])			V = {1'b0, V[0:126]}; // V = V >> 1;
		// else				V = {1'b0, V[0:126]} ^ {8'b11100001, 120'd0}; // V = V >> 1;
	// end
// end

// assign oResult = Z;


wire [0:127] Z [1:128];
wire [0:127] V [0:127];

wire [0:127] iR;
assign iR = {8'b1110_0001, 120'd0};

assign V[0] = iHashkey;
assign V[1] = {1'b0, V[0][0:126]} ^ (iR & {128{V[0][127]}});
assign V[2] = {1'b0, V[1][0:126]} ^ (iR & {128{V[1][127]}});
assign V[3] = {1'b0, V[2][0:126]} ^ (iR & {128{V[2][127]}});
assign V[4] = {1'b0, V[3][0:126]} ^ (iR & {128{V[3][127]}});
assign V[5] = {1'b0, V[4][0:126]} ^ (iR & {128{V[4][127]}});
assign V[6] = {1'b0, V[5][0:126]} ^ (iR & {128{V[5][127]}});
assign V[7] = {1'b0, V[6][0:126]} ^ (iR & {128{V[6][127]}});
assign V[8] = {1'b0, V[7][0:126]} ^ (iR & {128{V[7][127]}});
assign V[9] = {1'b0, V[8][0:126]} ^ (iR & {128{V[8][127]}});
assign V[10] = {1'b0, V[9][0:126]} ^ (iR & {128{V[9][127]}});
assign V[11] = {1'b0, V[10][0:126]} ^ (iR & {128{V[10][127]}});
assign V[12] = {1'b0, V[11][0:126]} ^ (iR & {128{V[11][127]}});
assign V[13] = {1'b0, V[12][0:126]} ^ (iR & {128{V[12][127]}});
assign V[14] = {1'b0, V[13][0:126]} ^ (iR & {128{V[13][127]}});
assign V[15] = {1'b0, V[14][0:126]} ^ (iR & {128{V[14][127]}});
assign V[16] = {1'b0, V[15][0:126]} ^ (iR & {128{V[15][127]}});
assign V[17] = {1'b0, V[16][0:126]} ^ (iR & {128{V[16][127]}});
assign V[18] = {1'b0, V[17][0:126]} ^ (iR & {128{V[17][127]}});
assign V[19] = {1'b0, V[18][0:126]} ^ (iR & {128{V[18][127]}});
assign V[20] = {1'b0, V[19][0:126]} ^ (iR & {128{V[19][127]}});
assign V[21] = {1'b0, V[20][0:126]} ^ (iR & {128{V[20][127]}});
assign V[22] = {1'b0, V[21][0:126]} ^ (iR & {128{V[21][127]}});
assign V[23] = {1'b0, V[22][0:126]} ^ (iR & {128{V[22][127]}});
assign V[24] = {1'b0, V[23][0:126]} ^ (iR & {128{V[23][127]}});
assign V[25] = {1'b0, V[24][0:126]} ^ (iR & {128{V[24][127]}});
assign V[26] = {1'b0, V[25][0:126]} ^ (iR & {128{V[25][127]}});
assign V[27] = {1'b0, V[26][0:126]} ^ (iR & {128{V[26][127]}});
assign V[28] = {1'b0, V[27][0:126]} ^ (iR & {128{V[27][127]}});
assign V[29] = {1'b0, V[28][0:126]} ^ (iR & {128{V[28][127]}});
assign V[30] = {1'b0, V[29][0:126]} ^ (iR & {128{V[29][127]}});
assign V[31] = {1'b0, V[30][0:126]} ^ (iR & {128{V[30][127]}});
assign V[32] = {1'b0, V[31][0:126]} ^ (iR & {128{V[31][127]}});
assign V[33] = {1'b0, V[32][0:126]} ^ (iR & {128{V[32][127]}});
assign V[34] = {1'b0, V[33][0:126]} ^ (iR & {128{V[33][127]}});
assign V[35] = {1'b0, V[34][0:126]} ^ (iR & {128{V[34][127]}});
assign V[36] = {1'b0, V[35][0:126]} ^ (iR & {128{V[35][127]}});
assign V[37] = {1'b0, V[36][0:126]} ^ (iR & {128{V[36][127]}});
assign V[38] = {1'b0, V[37][0:126]} ^ (iR & {128{V[37][127]}});
assign V[39] = {1'b0, V[38][0:126]} ^ (iR & {128{V[38][127]}});
assign V[40] = {1'b0, V[39][0:126]} ^ (iR & {128{V[39][127]}});
assign V[41] = {1'b0, V[40][0:126]} ^ (iR & {128{V[40][127]}});
assign V[42] = {1'b0, V[41][0:126]} ^ (iR & {128{V[41][127]}});
assign V[43] = {1'b0, V[42][0:126]} ^ (iR & {128{V[42][127]}});
assign V[44] = {1'b0, V[43][0:126]} ^ (iR & {128{V[43][127]}});
assign V[45] = {1'b0, V[44][0:126]} ^ (iR & {128{V[44][127]}});
assign V[46] = {1'b0, V[45][0:126]} ^ (iR & {128{V[45][127]}});
assign V[47] = {1'b0, V[46][0:126]} ^ (iR & {128{V[46][127]}});
assign V[48] = {1'b0, V[47][0:126]} ^ (iR & {128{V[47][127]}});
assign V[49] = {1'b0, V[48][0:126]} ^ (iR & {128{V[48][127]}});
assign V[50] = {1'b0, V[49][0:126]} ^ (iR & {128{V[49][127]}});
assign V[51] = {1'b0, V[50][0:126]} ^ (iR & {128{V[50][127]}});
assign V[52] = {1'b0, V[51][0:126]} ^ (iR & {128{V[51][127]}});
assign V[53] = {1'b0, V[52][0:126]} ^ (iR & {128{V[52][127]}});
assign V[54] = {1'b0, V[53][0:126]} ^ (iR & {128{V[53][127]}});
assign V[55] = {1'b0, V[54][0:126]} ^ (iR & {128{V[54][127]}});
assign V[56] = {1'b0, V[55][0:126]} ^ (iR & {128{V[55][127]}});
assign V[57] = {1'b0, V[56][0:126]} ^ (iR & {128{V[56][127]}});
assign V[58] = {1'b0, V[57][0:126]} ^ (iR & {128{V[57][127]}});
assign V[59] = {1'b0, V[58][0:126]} ^ (iR & {128{V[58][127]}});
assign V[60] = {1'b0, V[59][0:126]} ^ (iR & {128{V[59][127]}});
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
assign Z[109] = Z[108] ^ (V[108] & {128{iCtext[108]}});
assign Z[110] = Z[109] ^ (V[109] & {128{iCtext[109]}});
assign Z[111] = Z[110] ^ (V[110] & {128{iCtext[110]}});
assign Z[112] = Z[111] ^ (V[111] & {128{iCtext[111]}});
assign Z[113] = Z[112] ^ (V[112] & {128{iCtext[112]}});
assign Z[114] = Z[113] ^ (V[113] & {128{iCtext[113]}});
assign Z[115] = Z[114] ^ (V[114] & {128{iCtext[114]}});
assign Z[116] = Z[115] ^ (V[115] & {128{iCtext[115]}});
assign Z[117] = Z[116] ^ (V[116] & {128{iCtext[116]}});
assign Z[118] = Z[117] ^ (V[117] & {128{iCtext[117]}});
assign Z[119] = Z[118] ^ (V[118] & {128{iCtext[118]}});
assign Z[120] = Z[119] ^ (V[119] & {128{iCtext[119]}});
assign Z[121] = Z[120] ^ (V[120] & {128{iCtext[120]}});
assign Z[122] = Z[121] ^ (V[121] & {128{iCtext[121]}});
assign Z[123] = Z[122] ^ (V[122] & {128{iCtext[122]}});
assign Z[124] = Z[123] ^ (V[123] & {128{iCtext[123]}});
assign Z[125] = Z[124] ^ (V[124] & {128{iCtext[124]}});
assign Z[126] = Z[125] ^ (V[125] & {128{iCtext[125]}});
assign Z[127] = Z[126] ^ (V[126] & {128{iCtext[126]}});
assign Z[128] = Z[127] ^ (V[127] & {128{iCtext[127]}});

assign oResult = Z[128];

endmodule
