dngtuankiet/aes-gcm_128-256/source_v2_optim/testbench/tb.v

//======================================================================
//
// tb_aes_core.v
// -------------
// Testbench for the AES block cipher core.
//
//
// Author: Joachim Strombergson
// Copyright (c) 2014, Secworks Sweden AB
// All rights reserved.
//
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
// 1. Redistributions of source code must retain the above copyright
//    notice, this list of conditions and the following disclaimer.
//
// 2. Redistributions in binary form must reproduce the above copyright
//    notice, this list of conditions and the following disclaimer in
//    the documentation and/or other materials provided with the
//    distribution.
//
// THIS SOFTWARE IS PROVIDED BY THE COPYRIGHT HOLDERS AND CONTRIBUTORS
// "AS IS" AND ANY EXPRESS OR IMPLIED WARRANTIES, INCLUDING, BUT NOT
// LIMITED TO, THE IMPLIED WARRANTIES OF MERCHANTABILITY AND FITNESS
// FOR A PARTICULAR PURPOSE ARE DISCLAIMED. IN NO EVENT SHALL THE
// COPYRIGHT OWNER OR CONTRIBUTORS BE LIABLE FOR ANY DIRECT, INDIRECT,
// INCIDENTAL, SPECIAL, EXEMPLARY, OR CONSEQUENTIAL DAMAGES (INCLUDING,
// BUT NOT LIMITED TO, PROCUREMENT OF SUBSTITUTE GOODS OR SERVICES;
// LOSS OF USE, DATA, OR PROFITS; OR BUSINESS INTERRUPTION) HOWEVER
// CAUSED AND ON ANY THEORY OF LIABILITY, WHETHER IN CONTRACT,
// STRICT LIABILITY, OR TORT (INCLUDING NEGLIGENCE OR OTHERWISE)
// ARISING IN ANY WAY OUT OF THE USE OF THIS SOFTWARE, EVEN IF
// ADVISED OF THE POSSIBILITY OF SUCH DAMAGE.
//
//======================================================================
`timescale 1ns/1ps
//------------------------------------------------------------------
// Test module.
//------------------------------------------------------------------
module tb_aes_core();

  //----------------------------------------------------------------
  // Internal constant and parameter definitions.
  //----------------------------------------------------------------
  parameter DEBUG     = 0;
  parameter DUMP_WAIT = 0;

  parameter CLK_HALF_PERIOD = 5;
  parameter CLK_PERIOD = 2 * CLK_HALF_PERIOD;

  parameter AES_128_BIT_KEY = 0;
  parameter AES_256_BIT_KEY = 1;

  parameter AES_DECIPHER = 1'b0;
  parameter AES_ENCIPHER = 1'b1;


  //----------------------------------------------------------------
  // Register and Wire declarations.
  //----------------------------------------------------------------
  reg [31 : 0] cycle_ctr;
  reg [31 : 0] error_ctr;
  reg [31 : 0] tc_ctr;

  reg            tb_clk;
  reg            tb_reset_n;
  reg            tb_encdec;
  reg            tb_init;
  reg            tb_next;
  wire           tb_ready;
  reg [255 : 0]  tb_key;
  reg            tb_keylen;
  reg [127 : 0]  tb_block;
  wire [127 : 0] tb_result;
  wire           tb_result_valid;


  //----------------------------------------------------------------
  // Device Under Test.
  //----------------------------------------------------------------
  aes_core_TOP dut(
	.ICLK			(tb_clk),
	.IRSTN			(tb_reset_n),
	.IENCDEC		(tb_encdec),
	.IINIT			(tb_init),
	.INEXT			(tb_next),
	.OREADY			(tb_ready),
	.IKEY			(tb_key),
	.IKEYLEN		(tb_keylen),
	.IBLOCK			(tb_block),
	.ORESULT		(tb_result),
	.ORESULT_VALID	()
  );

  //----------------------------------------------------------------
  // clk_gen
  //
  // Always running clock generator process.
  //----------------------------------------------------------------
  always
    begin : clk_gen
      #CLK_HALF_PERIOD;
      tb_clk = !tb_clk;
    end // clk_gen


  //----------------------------------------------------------------
  // sys_monitor()
  //
  // An always running process that creates a cycle counter and
  // conditionally displays information about the DUT.
  //----------------------------------------------------------------
  always
    begin : sys_monitor
      cycle_ctr = cycle_ctr + 1;
      #(CLK_PERIOD);
      if (DEBUG)
        begin
          dump_dut_state();
        end
    end


  //----------------------------------------------------------------
  // dump_dut_state()
  //
  // Dump the state of the dump when needed.
  //----------------------------------------------------------------
  task dump_dut_state;
    begin
      $display("State of DUT");
      $display("------------");
      $display("Inputs and outputs:");
      $display("encdec = 0x%01x, init = 0x%01x, next = 0x%01x",
               dut.IENCDEC, dut.IINIT, dut.INEXT);
      $display("keylen = 0x%01x, key  = 0x%032x ", dut.IKEYLEN, dut.IKEY);
      $display("block  = 0x%032x", dut.IBLOCK);
      $display("");
      $display("ready        = 0x%01x", dut.OREADY);
      $display("result_valid = 0x%01x, result = 0x%032x",
               dut.ORESULT_VALID, dut.ORESULT);
      $display("");
      $display("Encipher state::");
      $display("enc_ctrl = 0x%01x, round_ctr = 0x%01x",
               dut.U1.enc_block.enc_ctrl_reg, dut.U1.enc_block.round_ctr_reg);
      $display("");
    end
  endtask // dump_dut_state


  //----------------------------------------------------------------
  // dump_keys()
  //
  // Dump the keys in the key memory of the dut.
  //----------------------------------------------------------------
  task dump_keys;
    begin
      $display("State of key memory in DUT:");
      $display("key[00] = 0x%016x", dut.U1.keymem.key_mem0);
      $display("key[01] = 0x%016x", dut.U1.keymem.key_mem1);
      $display("key[02] = 0x%016x", dut.U1.keymem.key_mem2);
      $display("key[03] = 0x%016x", dut.U1.keymem.key_mem3);
      $display("key[04] = 0x%016x", dut.U1.keymem.key_mem4);
      $display("key[05] = 0x%016x", dut.U1.keymem.key_mem5);
      $display("key[06] = 0x%016x", dut.U1.keymem.key_mem6);
      $display("key[07] = 0x%016x", dut.U1.keymem.key_mem7);
      $display("key[08] = 0x%016x", dut.U1.keymem.key_mem8);
      $display("key[09] = 0x%016x", dut.U1.keymem.key_mem9);
      $display("key[10] = 0x%016x", dut.U1.keymem.key_mem10);
      $display("key[11] = 0x%016x", dut.U1.keymem.key_mem11);
      $display("key[12] = 0x%016x", dut.U1.keymem.key_mem12);
      $display("key[13] = 0x%016x", dut.U1.keymem.key_mem13);
      $display("key[14] = 0x%016x", dut.U1.keymem.key_mem14);
      $display("");
    end
  endtask // dump_keys


  //----------------------------------------------------------------
  // reset_dut()
  //
  // Toggle reset to put the DUT into a well known state.
  //----------------------------------------------------------------
  task reset_dut;
    begin
      $display("*** Toggle reset.");
      tb_reset_n = 0;
      #(2 * CLK_PERIOD);
      tb_reset_n = 1;
    end
  endtask // reset_dut


  //----------------------------------------------------------------
  // init_sim()
  //
  // Initialize all counters and testbed functionality as well
  // as setting the DUT inputs to defined values.
  //----------------------------------------------------------------
  task init_sim;
    begin
      cycle_ctr = 0;
      error_ctr = 0;
      tc_ctr    = 0;

      tb_clk     = 0;
      tb_reset_n = 1;
      tb_encdec  = 0;
      tb_init    = 0;
      tb_next    = 0;
      tb_key     = {8{32'h00000000}};
      tb_keylen  = 0;

      tb_block  = {4{32'h00000000}};
    end
  endtask // init_sim


  //----------------------------------------------------------------
  // display_test_result()
  //
  // Display the accumulated test results.
  //----------------------------------------------------------------
  task display_test_result;
    begin
      if (error_ctr == 0)
        begin
          $display("*** All %02d test cases completed successfully", tc_ctr);
        end
      else
        begin
          $display("*** %02d tests completed - %02d test cases did not complete successfully.",
                   tc_ctr, error_ctr);
        end
    end
  endtask // display_test_result


  //----------------------------------------------------------------
  // wait_ready()
  //
  // Wait for the ready flag in the dut to be set.
  //
  // Note: It is the callers responsibility to call the function
  // when the dut is actively processing and will in fact at some
  // point set the flag.
  //----------------------------------------------------------------
  task wait_ready;
    begin
      while (!tb_ready)
        begin
          #(CLK_PERIOD);
          if (DUMP_WAIT)
            begin
              dump_dut_state();
            end
        end
    end
  endtask // wait_ready


  //----------------------------------------------------------------
  // wait_valid()
  //
  // Wait for the result_valid flag in the dut to be set.
  //
  // Note: It is the callers responsibility to call the function
  // when the dut is actively processing a block and will in fact
  // at some point set the flag.
  //----------------------------------------------------------------
  task wait_valid;
    begin
      while (!tb_result_valid)
        begin
          #(CLK_PERIOD);
        end
    end
  endtask // wait_valid


  //----------------------------------------------------------------
  // ecb_mode_single_block_test()
  //
  // Perform ECB mode encryption or decryption single block test.
  //----------------------------------------------------------------
  task ecb_mode_single_block_test(input [7 : 0]   tc_number,
                                  input           encdec,
                                  input [255 : 0] key,
                                  input           key_length,
                                  input [127 : 0] block,
                                  input [127 : 0] expected);
   begin
     $display("*** TC %0d ECB mode test started.", tc_number);
     tc_ctr = tc_ctr + 1;

     // Init the cipher with the given key and length.
     tb_key = key;
     tb_keylen = key_length;
     tb_init = 1;
     #(2 * CLK_PERIOD);
     tb_init = 0;
     wait_ready();

     $display("Key expansion done");
     $display("");

     dump_keys();


     // Perform encipher och decipher operation on the block.
     tb_encdec = encdec;
     tb_block = block;
     tb_next = 1;
     #(2 * CLK_PERIOD);
     tb_next = 0;
     wait_ready();

     if (tb_result == expected)
       begin
         $display("*** TC %0d successful.", tc_number);
         $display("");
       end
     else
       begin
         $display("*** ERROR: TC %0d NOT successful.", tc_number);
         $display("Expected: 0x%032x", expected);
         $display("Got:      0x%032x", tb_result);
         $display("");

         error_ctr = error_ctr + 1;
       end
   end
  endtask // ecb_mode_single_block_test


  //----------------------------------------------------------------
  // aes_core_test
  // The main test functionality.
  //
  // Test cases taken from NIST SP 800-38A:
  // http://csrc.nist.gov/publications/nistpubs/800-38a/sp800-38a.pdf
  //----------------------------------------------------------------
  initial
    begin : aes_core_test
      reg [255 : 0] nist_aes128_key;
      reg [255 : 0] nist_aes256_key;

      reg [127 : 0] nist_plaintext0;
      reg [127 : 0] nist_plaintext1;
      reg [127 : 0] nist_plaintext2;
      reg [127 : 0] nist_plaintext3;

      reg [127 : 0] nist_ecb_128_enc_expected0;
      reg [127 : 0] nist_ecb_128_enc_expected1;
      reg [127 : 0] nist_ecb_128_enc_expected2;
      reg [127 : 0] nist_ecb_128_enc_expected3;

      reg [127 : 0] nist_ecb_256_enc_expected0;
      reg [127 : 0] nist_ecb_256_enc_expected1;
      reg [127 : 0] nist_ecb_256_enc_expected2;
      reg [127 : 0] nist_ecb_256_enc_expected3;

      nist_aes128_key = 256'h2b7e151628aed2a6abf7158809cf4f3c00000000000000000000000000000000;
      nist_aes256_key = 256'h603deb1015ca71be2b73aef0857d77811f352c073b6108d72d9810a30914dff4;

      nist_plaintext0 = 128'h6bc1bee22e409f96e93d7e117393172a;
      nist_plaintext1 = 128'hae2d8a571e03ac9c9eb76fac45af8e51;
      nist_plaintext2 = 128'h30c81c46a35ce411e5fbc1191a0a52ef;
      nist_plaintext3 = 128'hf69f2445df4f9b17ad2b417be66c3710;

      nist_ecb_128_enc_expected0 = 128'h3ad77bb40d7a3660a89ecaf32466ef97;
      nist_ecb_128_enc_expected1 = 128'hf5d3d58503b9699de785895a96fdbaaf;
      nist_ecb_128_enc_expected2 = 128'h43b1cd7f598ece23881b00e3ed030688;
      nist_ecb_128_enc_expected3 = 128'h7b0c785e27e8ad3f8223207104725dd4;

      nist_ecb_256_enc_expected0 = 128'hf3eed1bdb5d2a03c064b5a7e3db181f8;
      nist_ecb_256_enc_expected1 = 128'h591ccb10d410ed26dc5ba74a31362870;
      nist_ecb_256_enc_expected2 = 128'hb6ed21b99ca6f4f9f153e7b1beafed1d;
      nist_ecb_256_enc_expected3 = 128'h23304b7a39f9f3ff067d8d8f9e24ecc7;


      $display("   -= Testbench for aes core started =-");
      $display("     ================================");
      $display("");

      init_sim();
      dump_dut_state();
      reset_dut();
      dump_dut_state();


      $display("ECB 128 bit key tests");
      $display("---------------------");
      ecb_mode_single_block_test(8'h01, AES_ENCIPHER, nist_aes128_key, AES_128_BIT_KEY,
                                 nist_plaintext0, nist_ecb_128_enc_expected0);

     ecb_mode_single_block_test(8'h02, AES_ENCIPHER, nist_aes128_key, AES_128_BIT_KEY,
                                nist_plaintext1, nist_ecb_128_enc_expected1);

     ecb_mode_single_block_test(8'h03, AES_ENCIPHER, nist_aes128_key, AES_128_BIT_KEY,
                                nist_plaintext2, nist_ecb_128_enc_expected2);

     ecb_mode_single_block_test(8'h04, AES_ENCIPHER, nist_aes128_key, AES_128_BIT_KEY,
                                nist_plaintext3, nist_ecb_128_enc_expected3);


      ecb_mode_single_block_test(8'h05, AES_DECIPHER, nist_aes128_key, AES_128_BIT_KEY,
                                 nist_ecb_128_enc_expected0, nist_plaintext0);

      ecb_mode_single_block_test(8'h06, AES_DECIPHER, nist_aes128_key, AES_128_BIT_KEY,
                                 nist_ecb_128_enc_expected1, nist_plaintext1);

      ecb_mode_single_block_test(8'h07, AES_DECIPHER, nist_aes128_key, AES_128_BIT_KEY,
                                 nist_ecb_128_enc_expected2, nist_plaintext2);

      ecb_mode_single_block_test(8'h08, AES_DECIPHER, nist_aes128_key, AES_128_BIT_KEY,
                                 nist_ecb_128_enc_expected3, nist_plaintext3);


      $display("");
      $display("ECB 256 bit key tests");
      $display("---------------------");
      ecb_mode_single_block_test(8'h10, AES_ENCIPHER, nist_aes256_key, AES_256_BIT_KEY,
                                 nist_plaintext0, nist_ecb_256_enc_expected0);

      ecb_mode_single_block_test(8'h11, AES_ENCIPHER, nist_aes256_key, AES_256_BIT_KEY,
                                 nist_plaintext1, nist_ecb_256_enc_expected1);

      ecb_mode_single_block_test(8'h12, AES_ENCIPHER, nist_aes256_key, AES_256_BIT_KEY,
                                 nist_plaintext2, nist_ecb_256_enc_expected2);

      ecb_mode_single_block_test(8'h13, AES_ENCIPHER, nist_aes256_key, AES_256_BIT_KEY,
                                 nist_plaintext3, nist_ecb_256_enc_expected3);


      ecb_mode_single_block_test(8'h14, AES_DECIPHER, nist_aes256_key, AES_256_BIT_KEY,
                                 nist_ecb_256_enc_expected0, nist_plaintext0);

      ecb_mode_single_block_test(8'h15, AES_DECIPHER, nist_aes256_key, AES_256_BIT_KEY,
                                 nist_ecb_256_enc_expected1, nist_plaintext1);

      ecb_mode_single_block_test(8'h16, AES_DECIPHER, nist_aes256_key, AES_256_BIT_KEY,
                                 nist_ecb_256_enc_expected2, nist_plaintext2);

      ecb_mode_single_block_test(8'h17, AES_DECIPHER, nist_aes256_key, AES_256_BIT_KEY,
                                 nist_ecb_256_enc_expected3, nist_plaintext3);


      display_test_result();
      $display("");
      $display("*** AES core simulation done. ***");
      //$finish;
    end // aes_core_test
endmodule // tb_aes_core

//======================================================================
// EOF tb_aes_core.v
//======================================================================
