dngtuankiet/aes-gcm_128-256/(commit log)

2021-07-13 modelsim folder
    [verilog.psm]
2021-07-29 edit Ctext case
2021-08-10 update pin count
2021-08-20 update working source
    [verilog.psm]
